kruglovvs/sound-amplifier/README.md

# Усилитель мощности звуковых частот
Это моё задание для практики на 3 курсе МГТУ по направлению "Конструирование и технология электронных средств". Задача сделать электронное устройство на основе данной схемы (УМЗЧ).
