kruglovvs/sound-amplifier/Docs/pcb_spec_a4.pdf

Копировал | Формат A4 Инв. № подл. Подп. и дата Взам. инв. № Инв. № дубл. Подп. и дата Справ. № Перв. примен.
Изм. Лист № докум. | Подп. | Дата
Разраб. | Лит. | Лист | Листов
Пров.

Н. контр.
Утв.
1 | 2 Форм. | Зона | Поз. | Обозначение | Наименование | Кол. | Примечание
| | Документация
А2 | ИУ4.11.03.03.21.73.14.001 СБ | Сборочный чертёж
А3 | ИУ4.11.03.03.21.73.14.001 Э3 | Схема электрическая принципиальная
А4 | ИУ4.11.03.03.21.73.14.001 ПЭ3 | Перечень элементов
| | | Детали
А2 | 1 | ИУ4.11.03.03.21.73.14.002 | Плата печатная | 1
| Стандартные изделия
2 | Винт самонарезающий ST2,2x9,5-St-R-Z | 2
| ГОСТ Р ИСО 7049-1-2012
| Прочие изделия
| Конденсаторы
3 | К78-630В-1мкФ±10% | 1 | C1
4 | К78-630В-0,1мкФ±10% | 3 | C2, C3, С9
5 | К50-63В-470мкФ±10% | 2 | C4, C5
6 | К50-63В-22мкФ±5% | 1 | C6
7 | К78-630В-47пФ±5% | 2 | C7, C8
| Резисторы
8 | C2-33Н-0,125Вт-22кОм±5% | 1 | R1
9 | C2-33Н-0,125Вт-2,2кОм±5% | 1 | R2
10 | C2-33Н-0,125Вт-560Ом±5% | 1 | R3
11 | C2-33Н-0,125Вт-18кОм±5% | 1 | R4
12 | C2-33Н-0,125Вт-1кОм±5% | 1 | R5
13 | C2-33Н-0,125Вт-27кОм±5% | 1 | R6
14 | C2-33Н-0,125Вт-4,7кОм±5% | 1 | R7
15 | Резистор переменный 3296W-1-101 (Bourns, США) 1 | | R8
| | ИУ4.11.03.03.21.73.14.001

УМЗЧ на биполярных транзисторах
Спецификация | МГТУ им. Н. Э. Баумана
| Кафедра ИУ4
| Группа ИУ4-73Б

Круглов В. С.
Селиванов К. В.

Копировал | Формат A4 Инв. № подл. Подп. и дата Взам. инв. № Инв. № дубл. Подп. и дата Справ. № Перв. примен.
Изм. Лист № докум. | Подп. | Дата

### Лист

2 Форм. | Зона | Поз. | Обозначение | Наименование | Кол. | Примечание
16 | C2-33Н-0,125Вт-220Ом±5% | 2 | R9, R10
17 | C2-33Н-2Вт-0,1Ом±5% | 2 | R11, R12
18 | C2-33Н-1Вт-10Ом±5% | 1 | R13
| Транзисторы
19 | 2N5401 (ON Semiconductor, США) | 2 | VT1, VT2
20 | BD139G (ON Semiconductor, США) | 2 | VT3, VT5
21 | MJE15032G (ON Semiconductor, США) | 1 | VT4
22 | BD140G (ON Semiconductor, США) | 1 | VT6
23 | TIP36CG (ON Semiconductor, США) | 1 | VT7
24 | TIP35CG (ON Semiconductor, США) | 1 | VT8
| Разъёмы
25 | micro-fit 3.0 430450821 (Molex, США) | 1 | XS1
26 | ACJS-MH (Amphenol, США) | 2 | XS2, XS3
27 | Радиатор охлаждения HS 107-30 | 2

ИУ4.11.03.03.21.73.14.001
