kruglovvs/sound-amplifier/Docs/paaf_spec_a4.pdf

Копировал | Формат A4 Инв. № подл. Подп. и дата Взам. инв. № Инв. № дубл. Подп. и дата Справ. № Перв. примен.
Изм. Лист № докум. | | Подп. | Дата
| Разраб. | Круглов В. С. | | Прибор УМЗЧ на биполярных транзисторах в сборе Спецификация | Лит. | Лист | Листов
| Пров. | Селиванов К. В.

Н. контр.
Утв.
1 Форм. | Зона | Поз. | Обозначение | Наименование | Кол. | Примечание
| | Документация
А2 | ИУ4.11.03.03.21.73.14.006 СБ | Сборочный чертёж
| | | Сборочные единицы
А4 | 1 | ИУ4.11.03.03.21.73.14.001 | УМЗЧ на биполярных транзисторах | 1
А4 | 2 | ИУ4.11.03.03.21.73.14.003 | Корпус в сборе | 1
| Стандартные изделия
3 | Винт со скругленной головкой M2,5x6-4,8-H | 4
| ГОСТ Р ИСО 7045-1-2013

ИУ4.11.03.03.21.73.14.006

МГТУ им. Н. Э. Баумана
Кафедра ИУ4
Группа ИУ4-73Б
