kruglovvs/sound-amplifier/Docs/package_spec_a4.pdf

Копировал | Формат A4 Инв. № подл. Подп. и дата Взам. инв. № Инв. № дубл. Подп. и дата Справ. № Перв. примен.
Изм. Лист № докум. | Подп. | Дата
Разраб. | Лит. | Лист | Листов
Пров.

Н. контр.
Утв.
1 Форм. | Зона | Поз. | Обозначение | Наименование | Кол. | Примечание
| | Документация
А2 | ИУ4.11.03.03.21.73.14.003 СБ | Сборочный чертёж
| | | Сборочные единицы
А2 | 1 | ИУ4.11.03.03.21.73.14.004 | Крышка корпуса | 1
А2 | 2 | ИУ4.11.03.03.21.73.14.005 | Основание корпуса | 1
| Стандартные изделия
3 | Винт с потайной головкой M2,5x20-4,8-H | 4
| ГОСТ Р ИСО 7046-1-2013

ИУ4.11.03.03.21.73.14.003

Корпус в сборе
Спецификация | МГТУ им. Н. Э. Баумана
| Кафедра ИУ4
| Группа ИУ4-73Б

Круглов В. С.
Селиванов К. В.
