kruglovvs/sound-amplifier/Docs/pcb_bomdoc_a4.pdf

Копировал | Формат A4 Инв. № подл. Подп. и дата Взам. инв. № Инв. № дубл. Подп. и дата Справ. № Перв. примен.
Изм. Лист № докум. | Подп. | Дата
Разраб. | Лит. | Лист | Листов
Пров.

Н. контр.
Утв.

1 2

Поз. обозначение | Наименование | Кол. | Примечание
| Конденсаторы
C1 | К78-630В-1мкФ±10% | 1
C2, C3, С9 | К78-630В-0,1мкФ±10% | 3
C4, C5 | К50-63В-470мкФ±10% | 2
C6 | К50-63В-22мкФ±5% | 1
C7, C8 | К78-630В-47пФ±5% | 2
| Резисторы
R1 | C2-33Н-0,125Вт-22кОм±5% | 1
R2 | C2-33Н-0,125Вт-2,2кОм±5% | 1
R3 | C2-33Н-0,125Вт-560Ом±5% | 1
R4 | C2-33Н-0,125Вт-18кОм±5% | 1
R5 | C2-33Н-0,125Вт-1кОм±5% | 1
R6 | C2-33Н-0,125Вт-27кОм±5% | 1
R7 | C2-33Н-0,125Вт-4,7кОм±5% | 1
R8 | Резистор переменный 3296W-1-101 (Bourns, США) | 1
R9, R10 | C2-33Н-0,125Вт-220Ом±5% | 2
R11, R12 | C2-33Н-2Вт-0,1Ом±5% | 2
R13 | C2-33Н-1Вт-10Ом±5% | 1
| Транзисторы
VT1, VT2 | 2N5401 (ON Semiconductor, США) | 2
VT3, VT5 | BD139G (ON Semiconductor, США) | 2
VT4 | MJE15032G (ON Semiconductor, США) | 1
VT6 | BD140G (ON Semiconductor, США) | 1
VT7 | TIP36CG (ON Semiconductor, США) | 1
VT8 | TIP35CG (ON Semiconductor, США) | 1

# ИУ4.11.03.03.21.73.14.001 ПЭ3

УМЗЧ на биполярных транзисторах
Перечень элементов | МГТУ им. Н. Э. Баумана
| Кафедра ИУ4

Группа ИУ4-73Б ИУ4.11.03.03.2¹.73.14.00¹

Круглов В. С.
Селиванов К. В.

Копировал | Формат A4 Инв. № подл. Подп. и дата Взам. инв. № Инв. № дубл. Подп. и дата Справ. № Перв. примен.
Изм. Лист № докум. | Подп. | Дата

### Лист

2

Поз. обозначение | Наименование | Кол. | Примечание
| Разъёмы
XS1 | micro-fit 3.0 430450821 (Molex, США) | 1
XS2, XS3 | ACJS-MH (Amphenol, США) | 2
Радиатор охлаждения HS 107-30 | 2

# ИУ4.11.03.03.21.73.14.001 ПЭ3 ИУ4.11.03.03.2¹.73.14.00¹
