kruglovvs/sound-amplifier/Hardware/Pcb-holder/Pcb Holder.stp

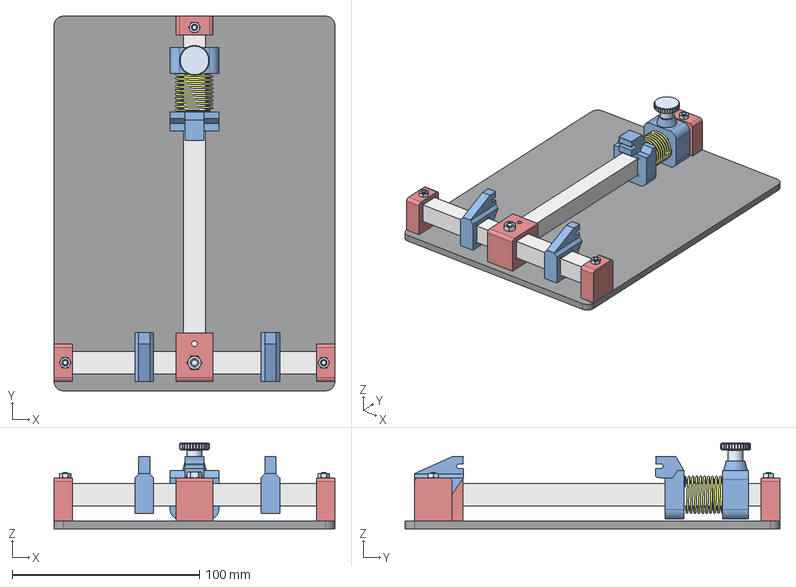
[picture p32: CAD file, 2024-09-01]
Hardware/Pcb-holder/Pcb Holder.stp
150.0 x 200.0 x 45.7 mm
瀇僔蠂縺
îñü1
îñü2
ïëàñòèê1
ïëàñòèê2 x 3
ïëàñòèê3 x 2
ïëàñòèê4
ïëàñòèê5
瀔鵵
Screw_DIN_7991_M3x30_v16.00 x 3
Screw_DIN_7991_M4x30_v16.00
Nut_DIN_934_1987_M3_v16.00 x 3
Nut_DIN_934_1987_M4_v16.00
Screw_DIN_464_M4x14_v17.00
