kruglovvs/sound-amplifier/Docs/cam_assembly_paaf_sample.pri_a3.pdf

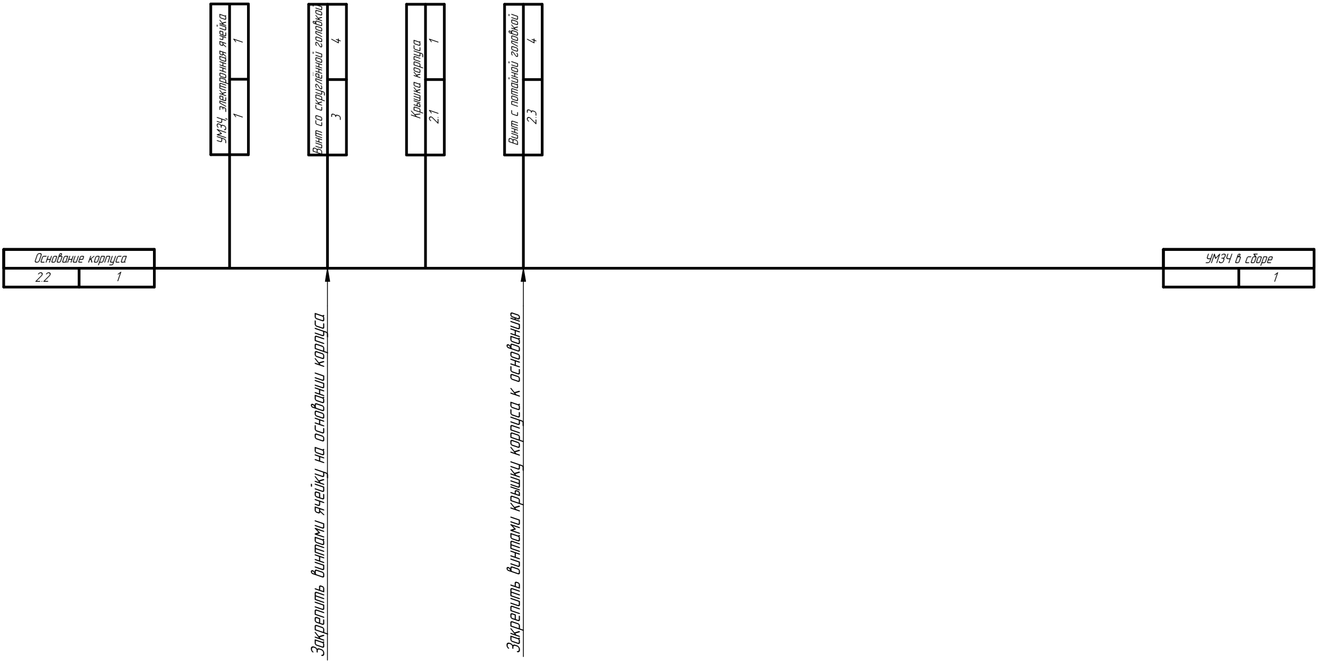
[picture p33: figure]
Основание корпуса

УМЗЧ в сборе ².1 1 1 | 3 | Крышка корпуса 1 | 4 Винт со скруглённой головкой УМЗЧ, электронная ячейка | 2.3 4 Винт с потайной головкой Закрепить винтами ячейку на основании корпуса | Закрепить винтами крышку корпуса к основанию
