kruglovvs/sound-amplifier/Docs/cam_assembly_pcb_manufac.pri_a3.pdf

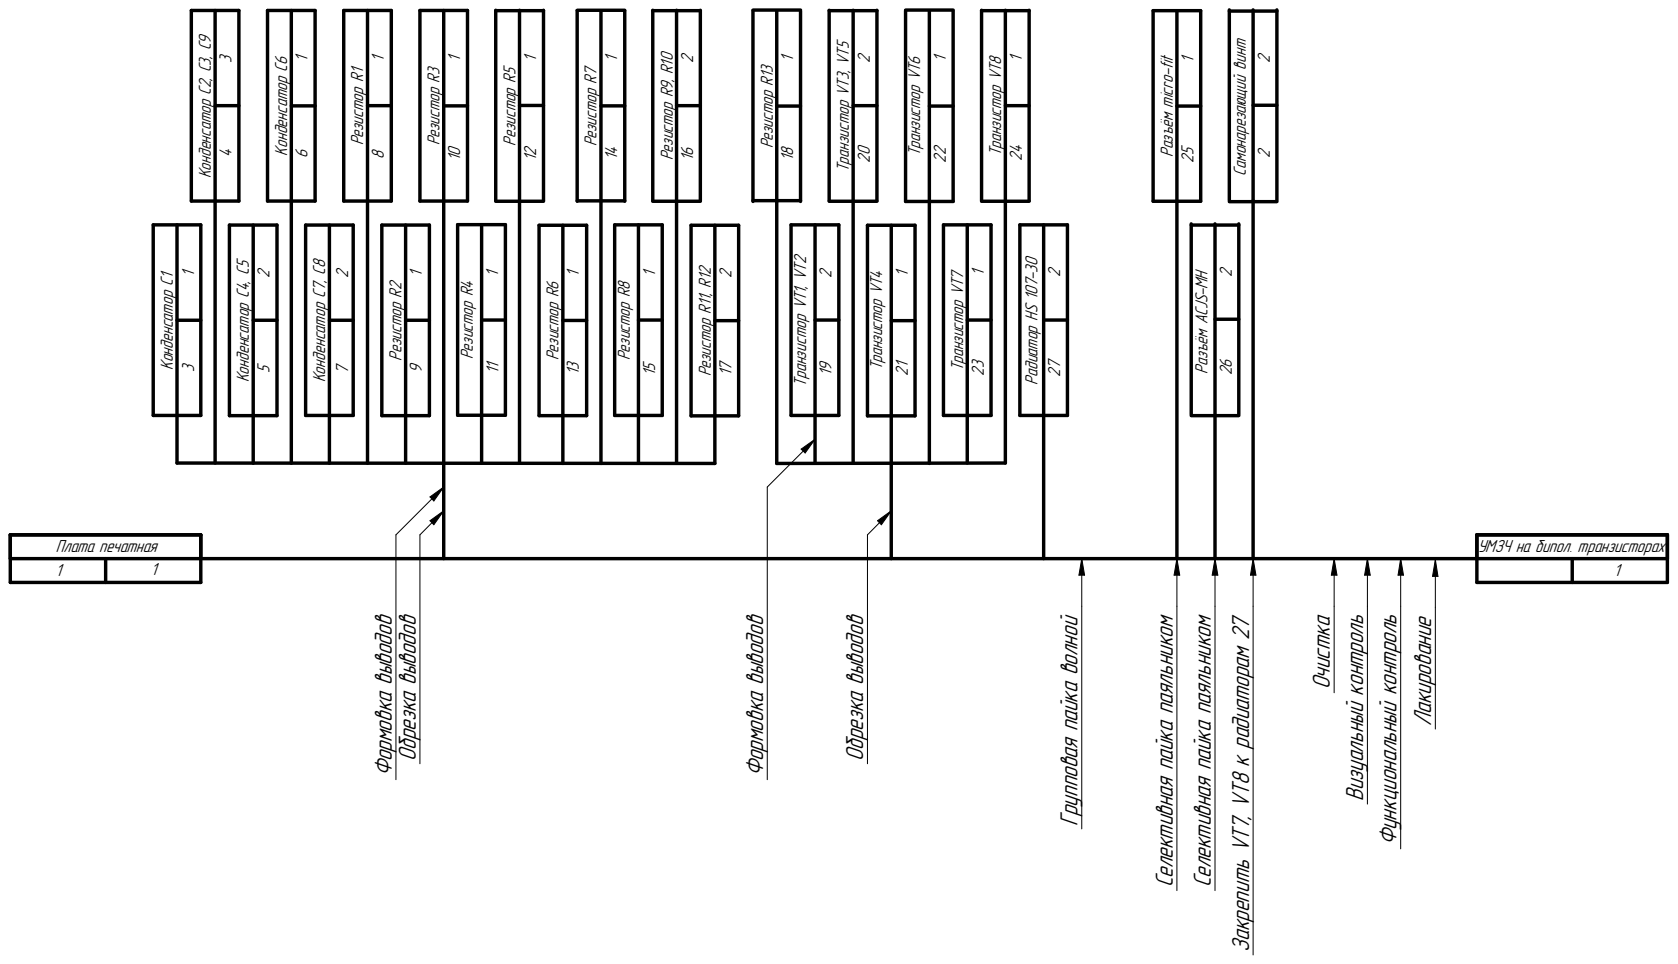
[picture p34: page 1]

2 Конденсатор C4, C5 Конденсатор C6 Конденсатор C7, C8 Резистор R1 Резистор R2 Конденсатор C2, C3, C9 Конденсатор C1
