kruglovvs/sound-amplifier/Docs/cam_assembly_pcb_sample.pri_a3.pdf

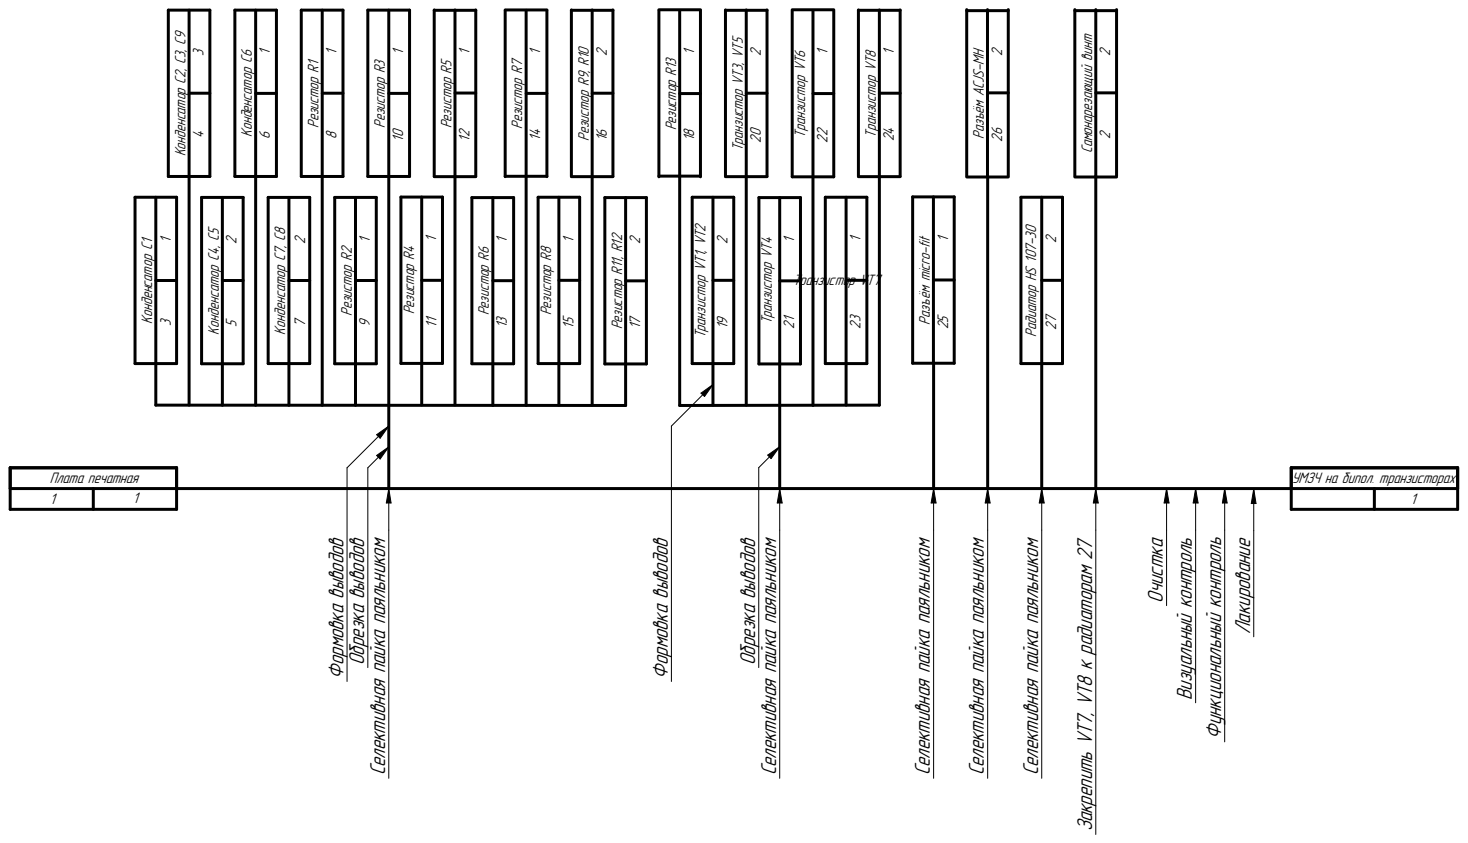
[picture p35: page 1]
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

УМЗЧ на бипол. транзисторах Радиатор HS ¹07-30 Разъём ACJS-MH Разъём micro-fit Транзистор VT8
