kruglovvs/sound-amplifier/Docs/assembled_a2.pdf

135 * ⁷⁵ *

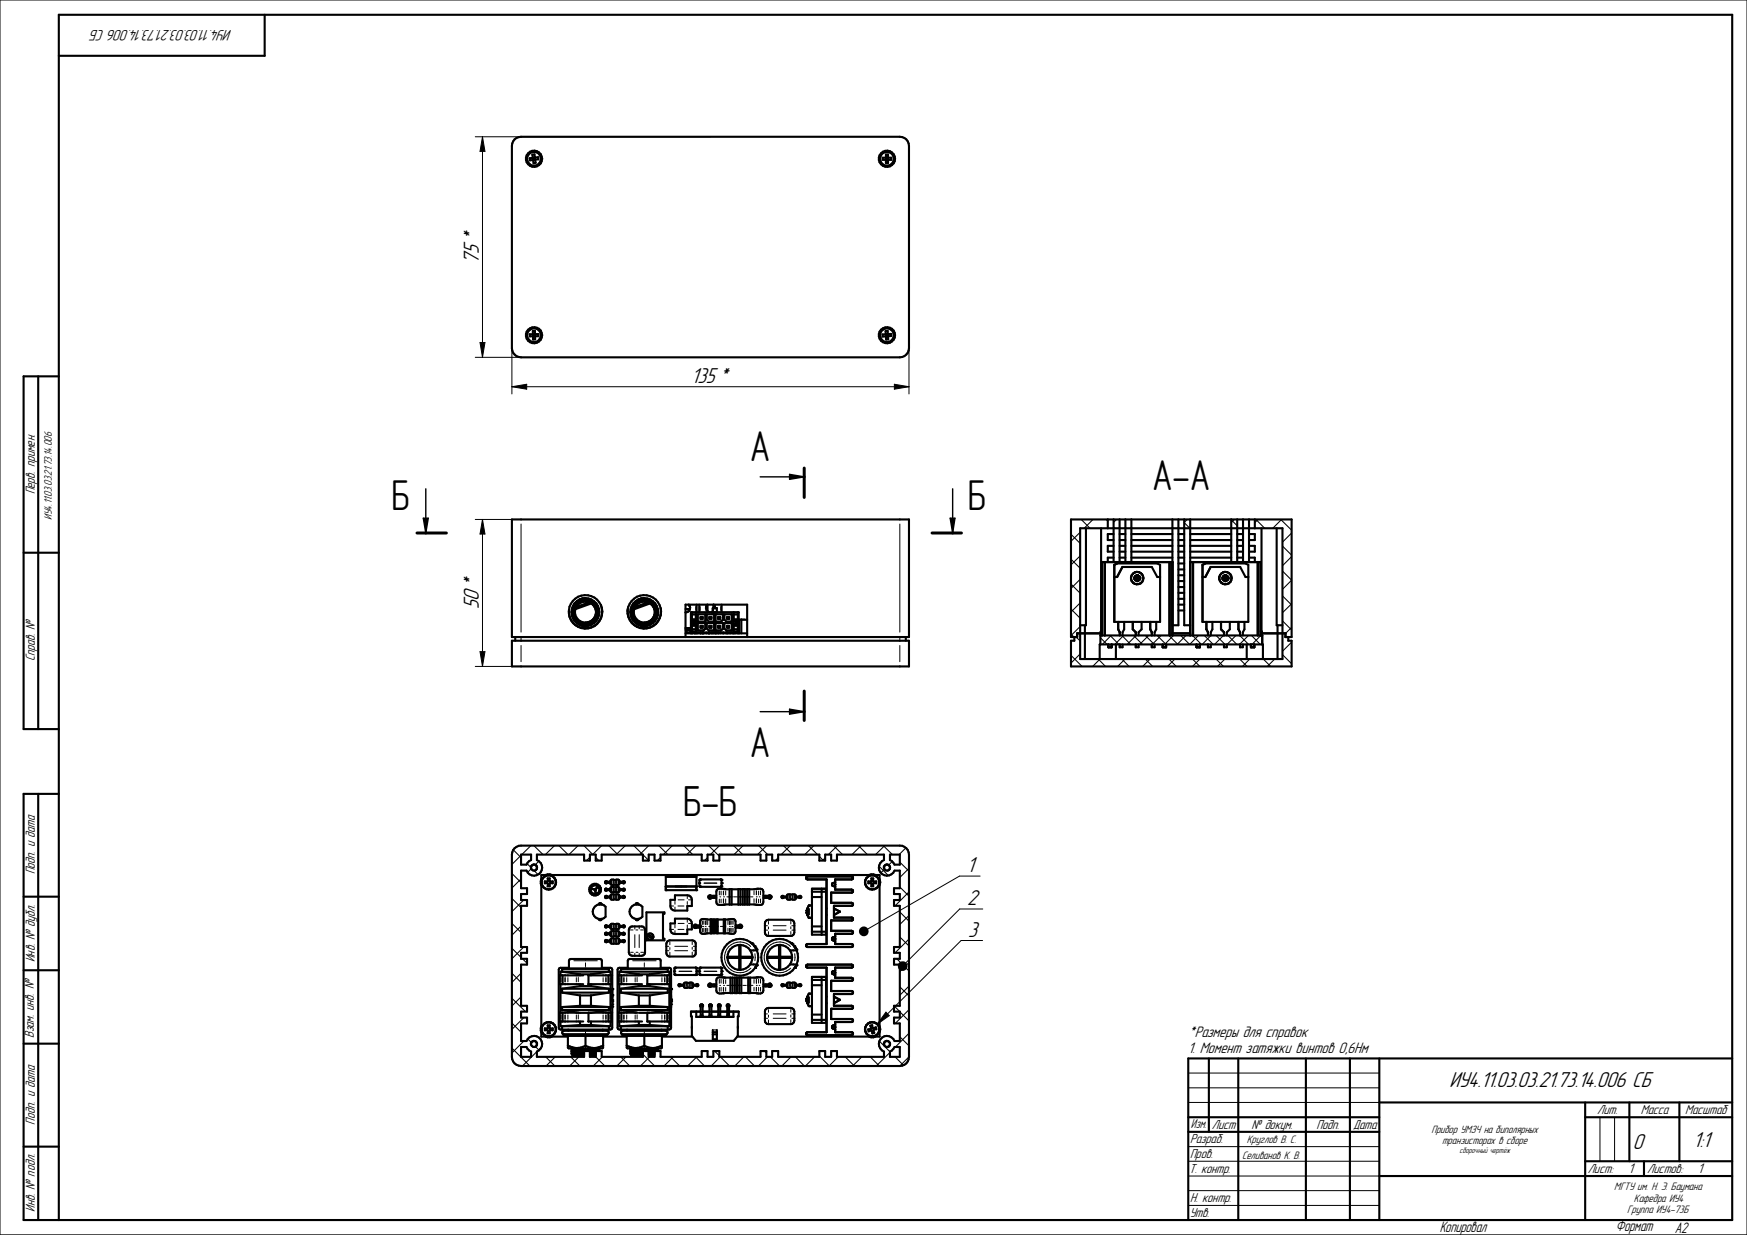
[picture p36: page 1]
Копировал; Формат A2

Инв. № подл. Подп. и дата Взам. инв. № Инв. № дубл. Подп. и дата Справ. № Перв. примен.

*Размеры для справок
1. Момент затяжки винтов 0,6Нм

Прибор УМЗЧ на биполярных транзисторах в сборе сборочный чертёж | Лит. | Масса | Масштаб

Изм. Лист | № докум. | Подп. | Дата | | | | | 0 1:1
Разраб. | Круглов В. С.
Пров. | Селиванов К. В.
Т. контр. | | | | Лист: 1 1 | Листов:

МГТУ им. Н. Э. Баумана Кафедра ИУ4 Группа ИУ4-73Б

Н. контр.
Утв.
