kruglovvs/sound-amplifier/Docs/pcb_assembled_a2.pdf

4 отв. | * O2,8 ¹ * | 29,8 * 6¹,4*

А

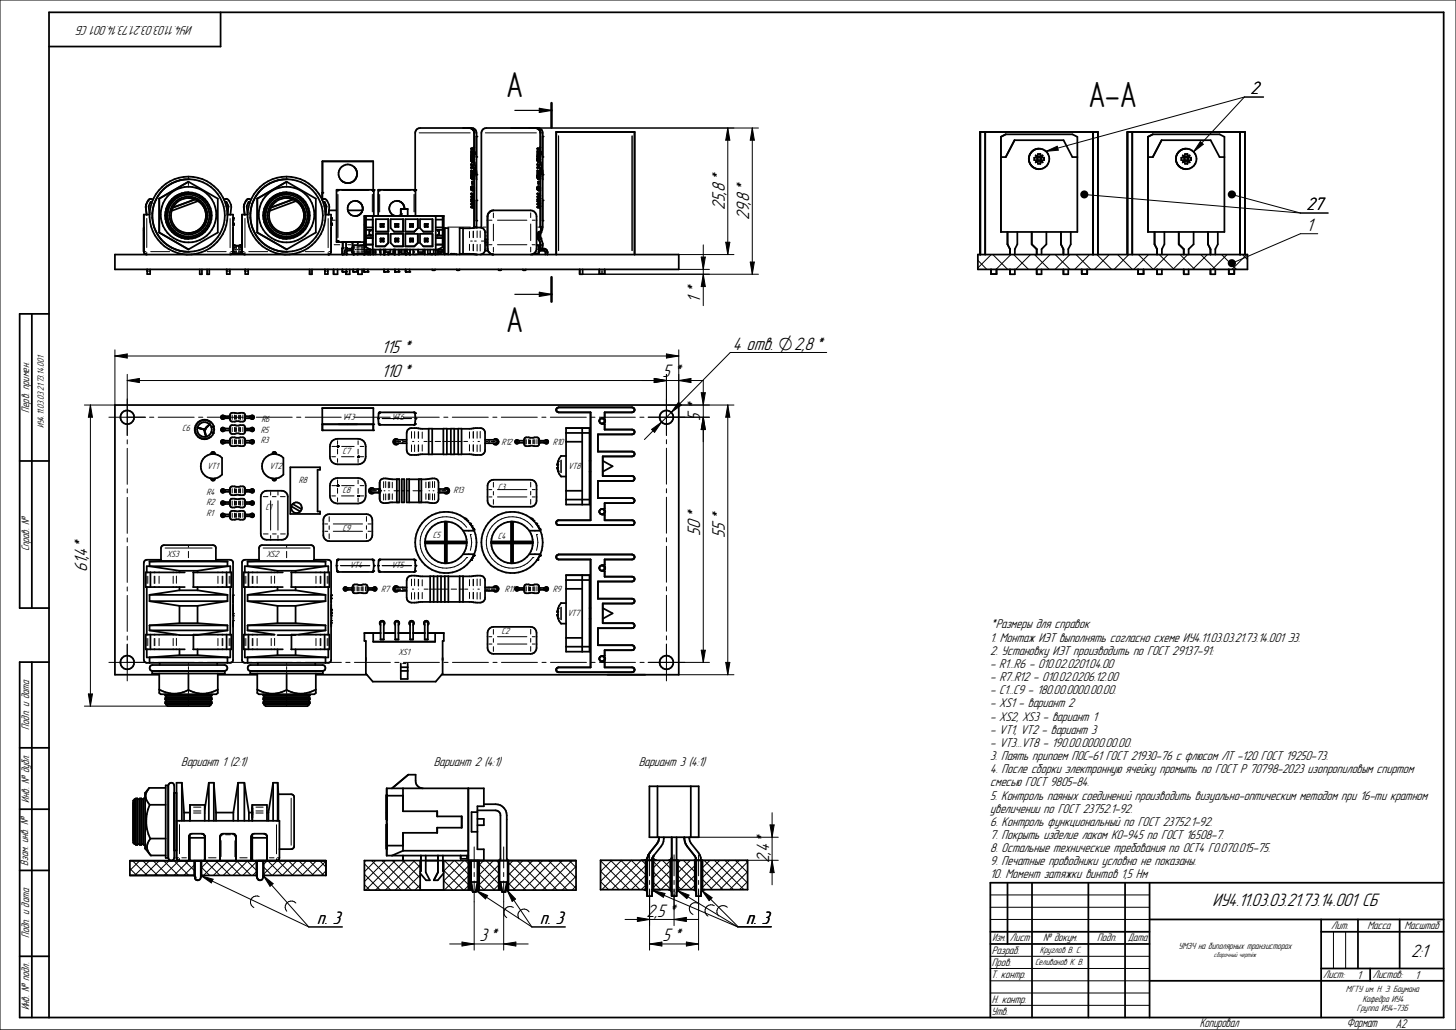
[picture p37: page 1]

Инв. № подл. Подп. и дата Взам. инв. № Инв. № дубл. Подп. и дата Справ. № Перв. примен.

*Размеры для справок
1. Монтаж ИЭТ выполнять согласно схеме ИУ4.11.03.03.21.73.14.001 Э3.
2. Установку ИЭТ производить по ГОСТ 29137-91:
- XS1 - вариант 2
- XS2, XS3 - вариант 1
- VT1, VT2 - вариант 3
3. Паять припоем ПОС-61 ГОСТ 21930-76 с флюсом ЛТ -120 ГОСТ 19250-73.
4. После сборки электронную ячейку промыть по ГОСТ Р 70798-2023 изопропиловым спиртом
смесью ГОСТ 9805-84.
5. Контроль паяных соединений производить визуально-оптическим методом при 16-ти кратном
увеличении по ГОСТ 23752.1-92.
6. Контроль функциональный по ГОСТ 23752.1-92.
7. Покрыть изделие лаком КО-945 по ГОСТ 16508-7.
8. Остальные технические требования по ОСТ4 ГО.070.015-75.
9. Печатные проводники условно не показаны.
10. Момент затяжки винтов 1,5 Нм

УМЗЧ на биполярных транзисторах сборочный чертёж | Лит. | Масса | Масштаб

Изм. Лист | № докум. | Подп. | Дата | | | | | 2:1
Разраб. | Круглов В. С.
Пров. | Селиванов К. В.
Т. контр. | | | | Лист: 1 1 | Листов:

МГТУ им. Н. Э. Баумана Кафедра ИУ4 Группа ИУ4-73Б

Н. контр.
Утв.
