kruglovvs/sound-amplifier/Docs/Pcb Holder.pri_a3.pdf

150 * 33,4* 45,7 *

30...100 **

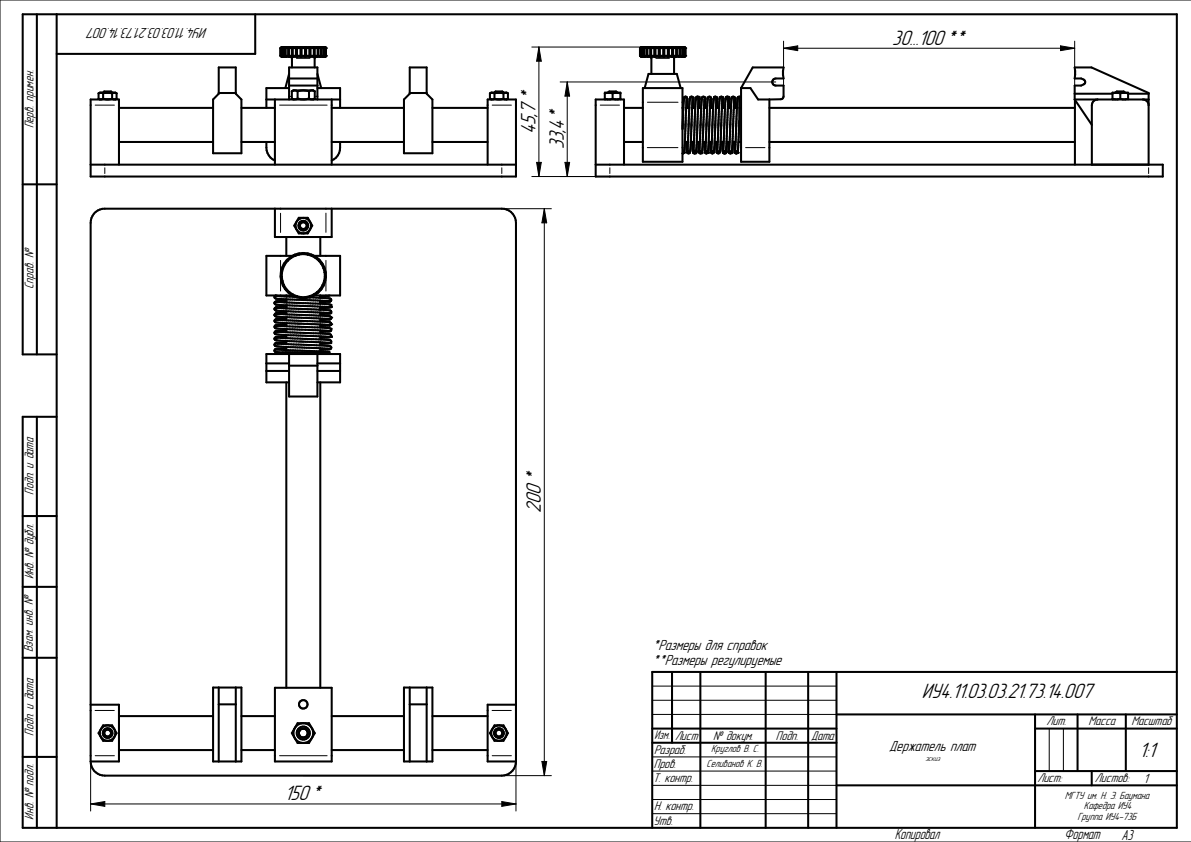
[picture p38: page 1]
Копировал; Формат A3

1:1 Инв. № подл. Подп. и дата Взам. инв. № Инв. № дубл. Подп. и дата Справ. № Перв. примен.

*Размеры для справок
**Размеры регулируемые

Держатель плат эскиз | Лит. | Масса | Масштаб

Изм. Лист | № докум. | Подп. | Дата
Разраб. | Круглов В. С.
Пров. | Селиванов К. В.
Т. контр. | | | | Лист: | Листов: 1

МГТУ им. Н. Э. Баумана Кафедра ИУ4 Группа ИУ4-73Б

Н. контр.
Утв.
