kruglovvs/sound-amplifier/Docs/pcb_a2.pdf

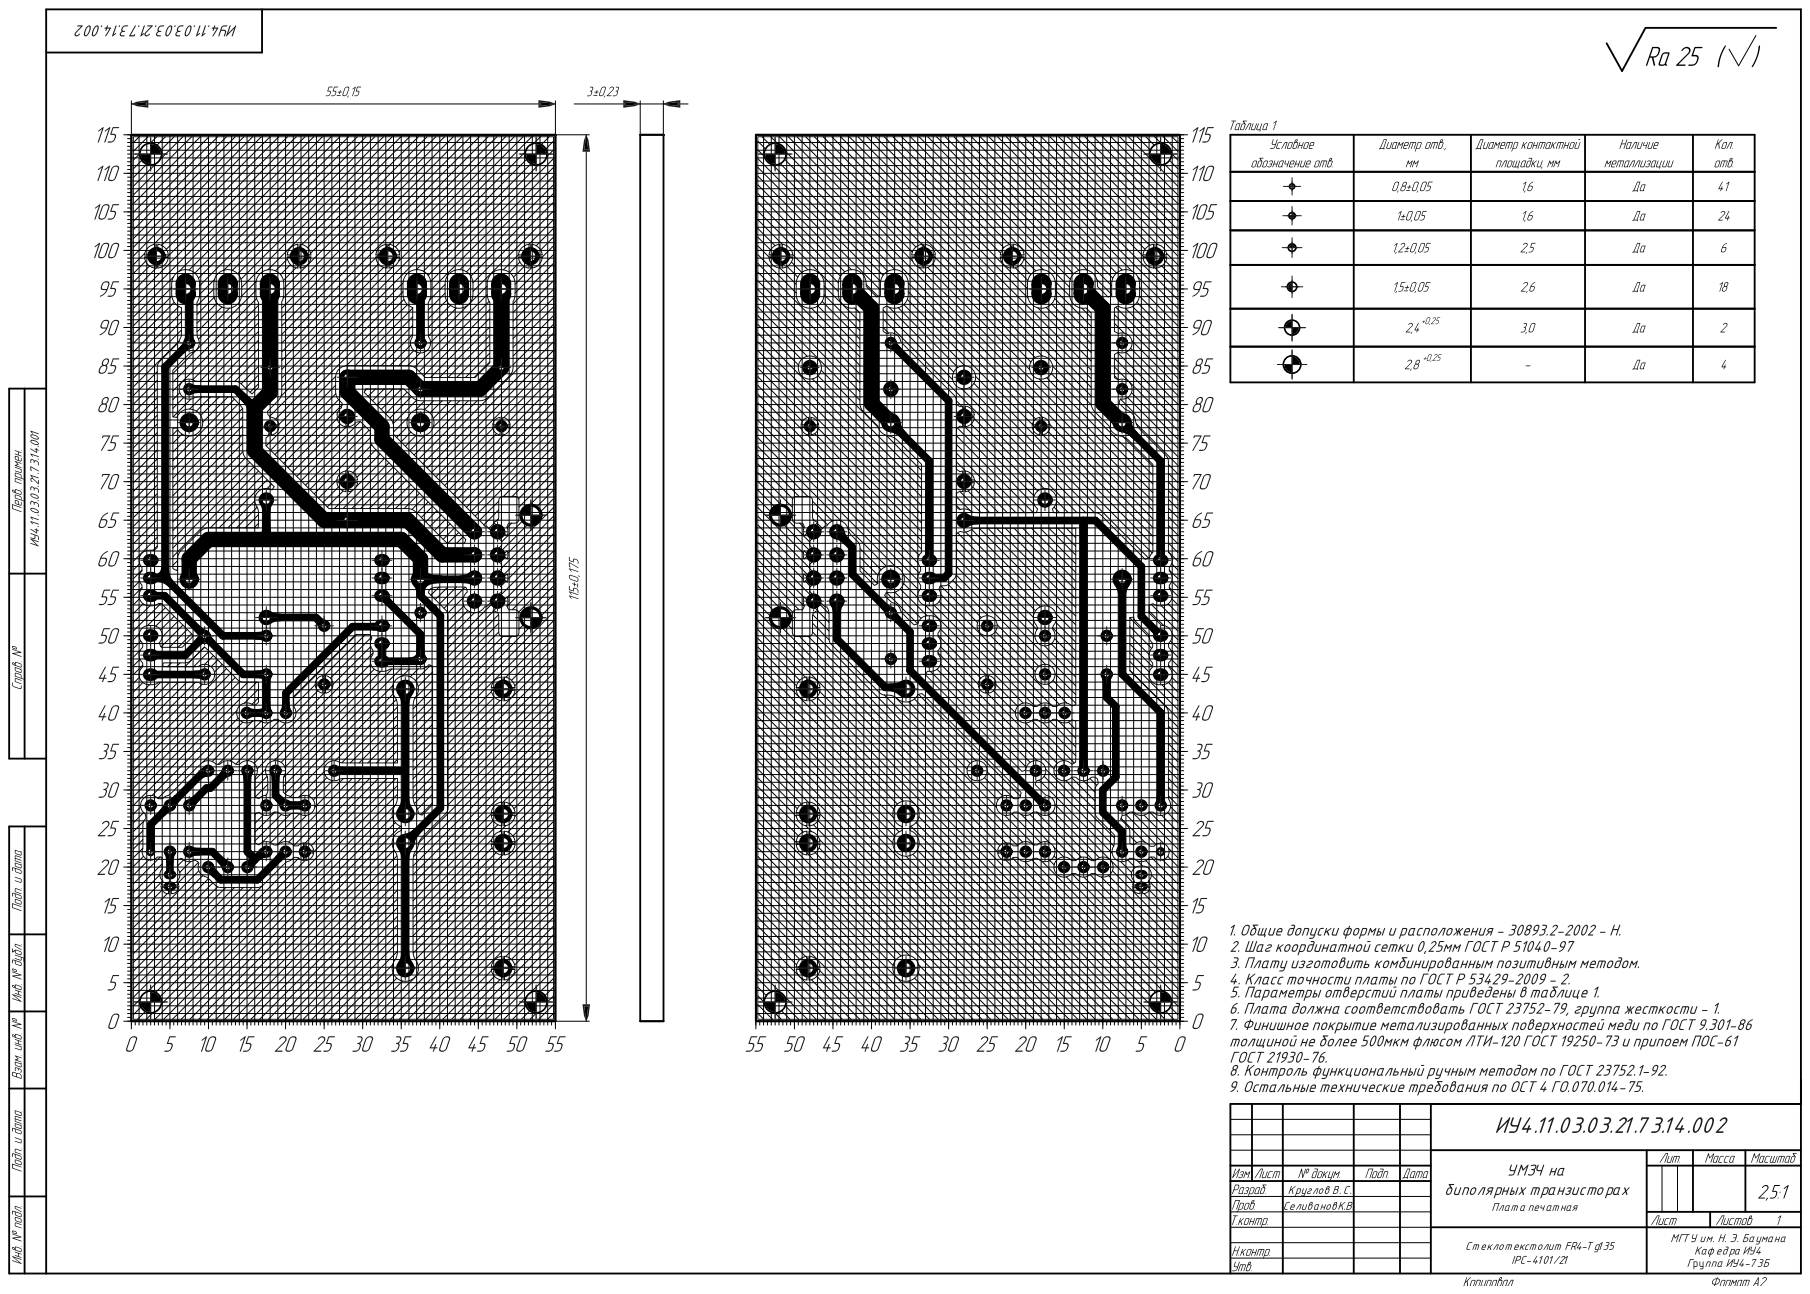
[picture p39: page 1]
