kruglovvs/sound-amplifier/Docs/body_a2.pdf

120

128,8

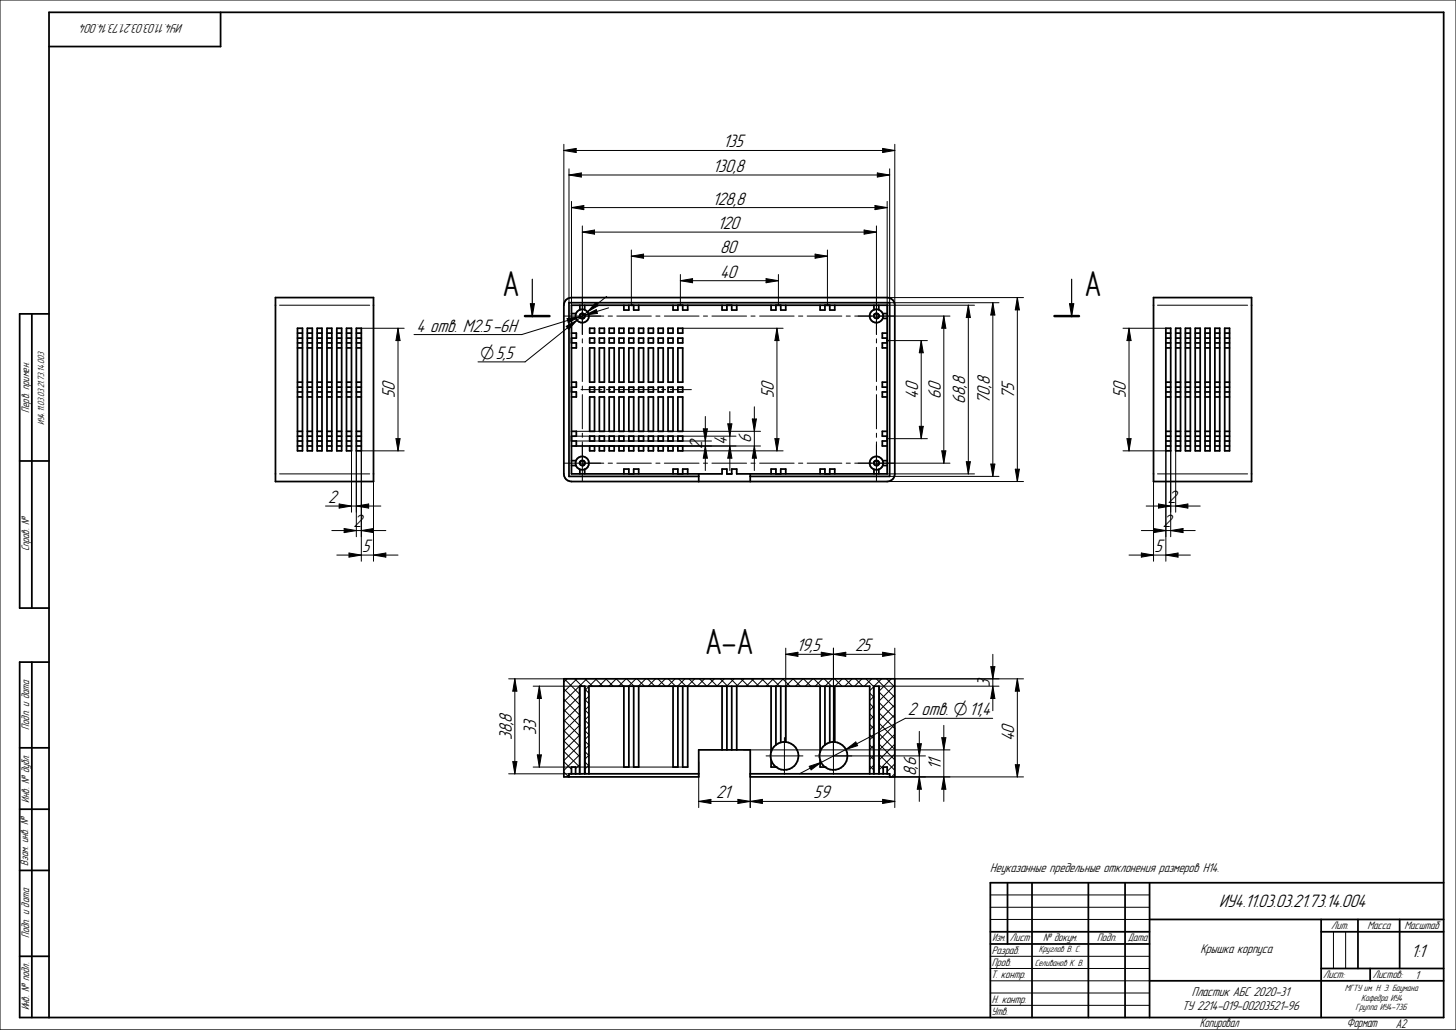
[picture p40: page 1]
Копировал; Формат A2; Селиванов К. В. ИУ4.11.03.03.2¹.73.14.003; 2 отв. O11,4 8,6; 4 отв.

Инв. № подл. Подп. и дата Взам. инв. № Инв. № дубл. Подп. и дата Справ. № Перв. примен.

Неуказанные предельные отклонения размеров H14.

Крышка корпуса | Лит. | Масса | Масштаб

Изм. Лист | № докум. | Подп. | Дата | | | | | 1:1
Разраб. | Круглов В. С.
Пров.
Т. контр. | | | | Лист: | Листов: 1

Пластик АБС 2020-31 ТУ 2214-019-00203521-96 | МГТУ им. Н. Э. Баумана Кафедра ИУ4 Группа ИУ4-73Б

Н. контр.
Утв.
