kruglovvs/sound-amplifier/Docs/cover_a3.pdf

А-А

ББ

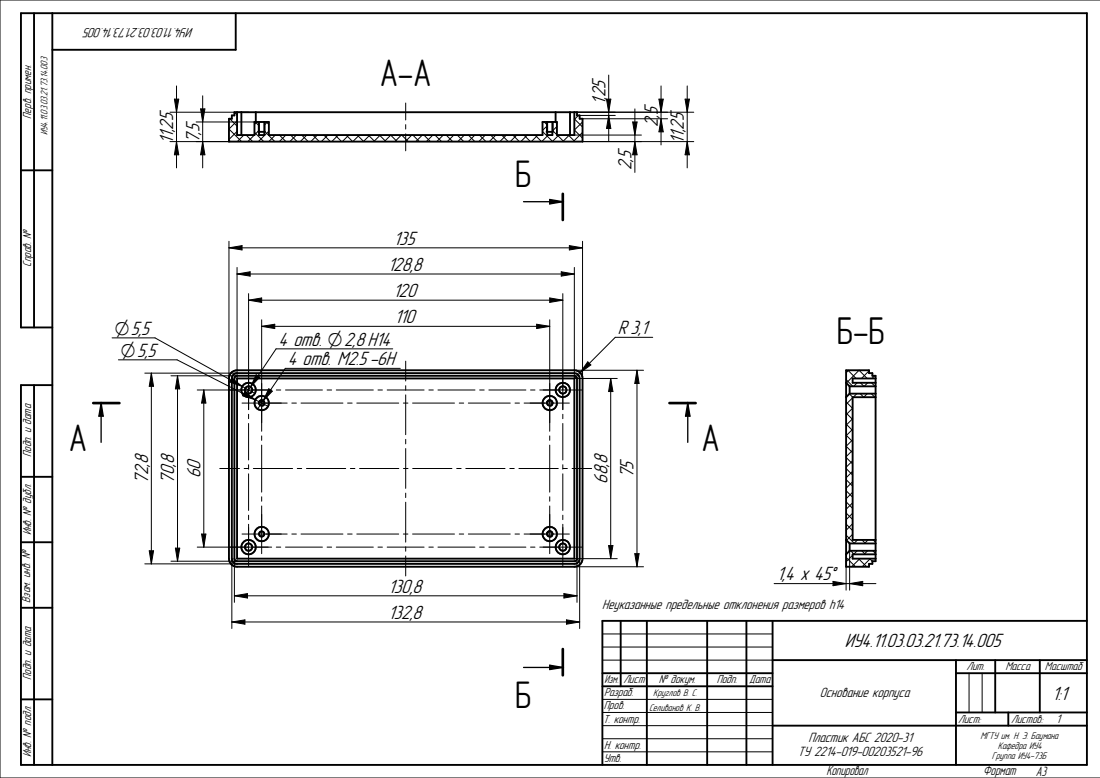
[picture p41: page 1]
Копировал; Формат A3; Б-Б ¹¹⁰; M2.54 отв.; 4 отв.

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

Неуказанные предельные отклонения размеров h14

Основание корпуса | Лит. | Масса | Масштаб

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

Н. контр.
Утв.
