kruglovvs/sound-amplifier/Docs/principal_a3.pdf

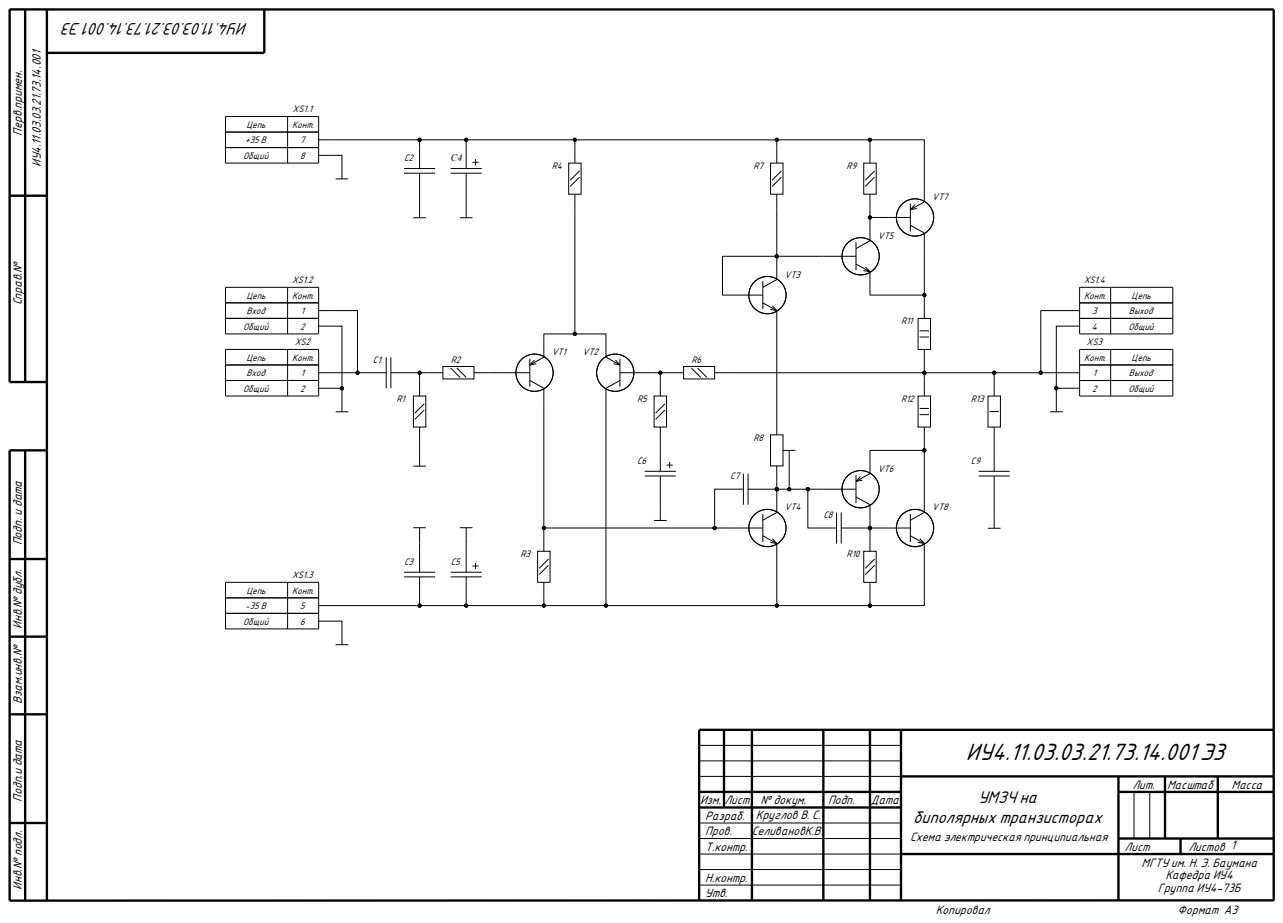
[picture p42: page 1]

Формат A3 Справ.№ Перв.примен.

Цепь | Конт.
+35 В | 7
Общий | 8

Инв.№ подл. Подп.и дата Взам.инв.№ Инв.№ дубл. Подп. и дата

-35 В | 5
Общий | 6

УМЗЧ на биполярных транзисторах Схема электрическая принципиальная | Лит. | Масштаб | Масса

Изм. | Лист | № докум. | Подп. | Дата
Разраб. | | Круглов В. С.
Пров. | | СеливановК.В.
Т.контр. | | | | | Лист | 1 Листов

МГТУ им. Н. Э. Баумана Кафедра ИУ4 Группа ИУ4-73Б

Н.контр.
Утв.
