kruglovvs/sound-amplifier/(list of files, drawings)

Other design files:
Hardware/Project/PAAF.PrjPcb
Hardware/Project/PCB.PcbDoc
Hardware/Project/principal.SchDoc
