kruglovvs/sound-amplifier/(commit log)

2024-07-26 Init commit
    PCB with phone jacks
    [PAAF.PrjPcb, Sheet.SchDoc]
2024-07-31 change pcb sizes for the G1098B case
    [PAAF.PrjPcb, Sheet.SchDoc]
2024-08-03 changed pcb sized for the standart case
    [PAAF.PrjPcb, Sheet.SchDoc]
2024-08-03 created 3d model
    [PAAF.PrjPcb, PCB.cfg, Sheet.SchDoc, principal.SchDoc]
2024-08-03 improve pcb teardrops
2024-08-04 created case model in solid edge
    [Assembled.cfg, PCB.cfg]
2024-08-04 created assembled cad model
    [Assembled.cfg, PCB.cfg]
2024-08-04 improved ventilation
    [Assembled.cfg, PCB.cfg]
2024-08-04 even more ventilation
    [Assembled.cfg]
2024-08-05 created case drawts and improved transistro's screws
    [Assembled.cfg, PAAF.PrjPcb, PCB.cfg, pcb.cfg]
2024-08-17 add sizes to dfts
    [Assembled.cfg, package.cfg]
2024-08-17 improve parts location in dfts
    [package.cfg]
2024-08-24 imrprove doc and create specifications
    [Assembled.cfg, BOM.xls, PCB.cfg, principal.SchDoc]
2024-08-24 create pcb assembled docs summary
    [PCB.PcbDoc, PCB.cfg]
2024-08-25 add doc names and specifications
    [PAAF.PrjPcb, PCB.PcbDoc, principal.SchDoc]
2024-08-26 create pdf docs from dfts
    [Assembled.cfg, BOM.xls, PAAF.PrjPcb, PCB.PcbDoc, PCB.cfg, package.cfg]
2024-09-01 complete docs
    [Pcb Holder.stp]
